StarchedPie/55-microswitch-discipline/README.md

# 55%
 55% keyboard using D2F microswitches, based on Coseyfannitutti's Discipline

[BOM, Build Guide, and Flashing Information](./doc)

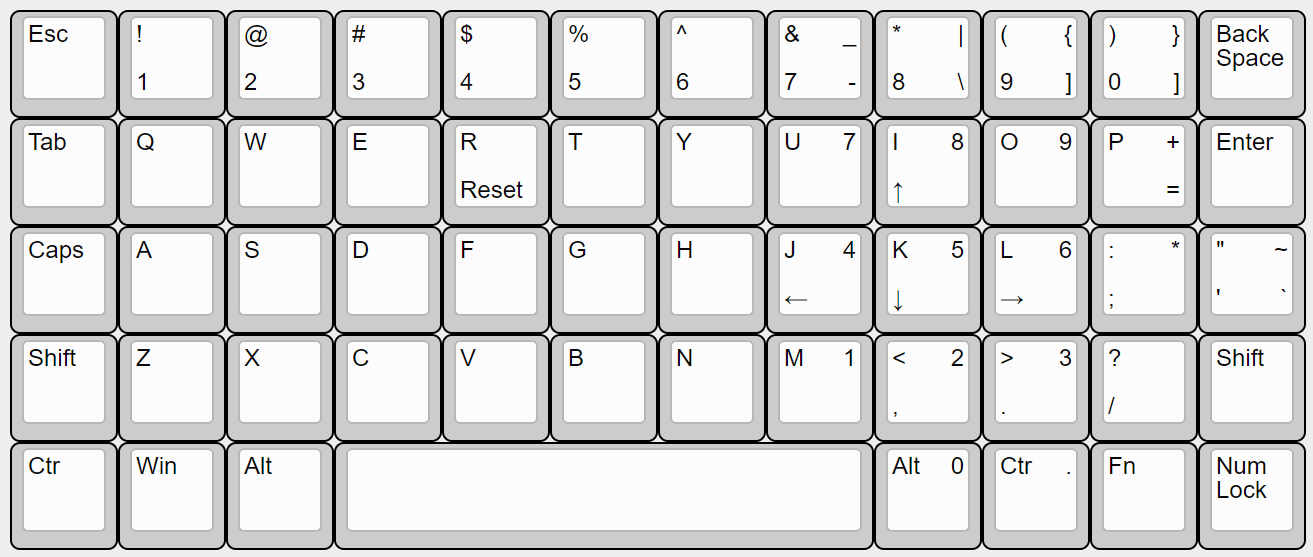
[picture p1: keycaps/Layout.png]
discipline

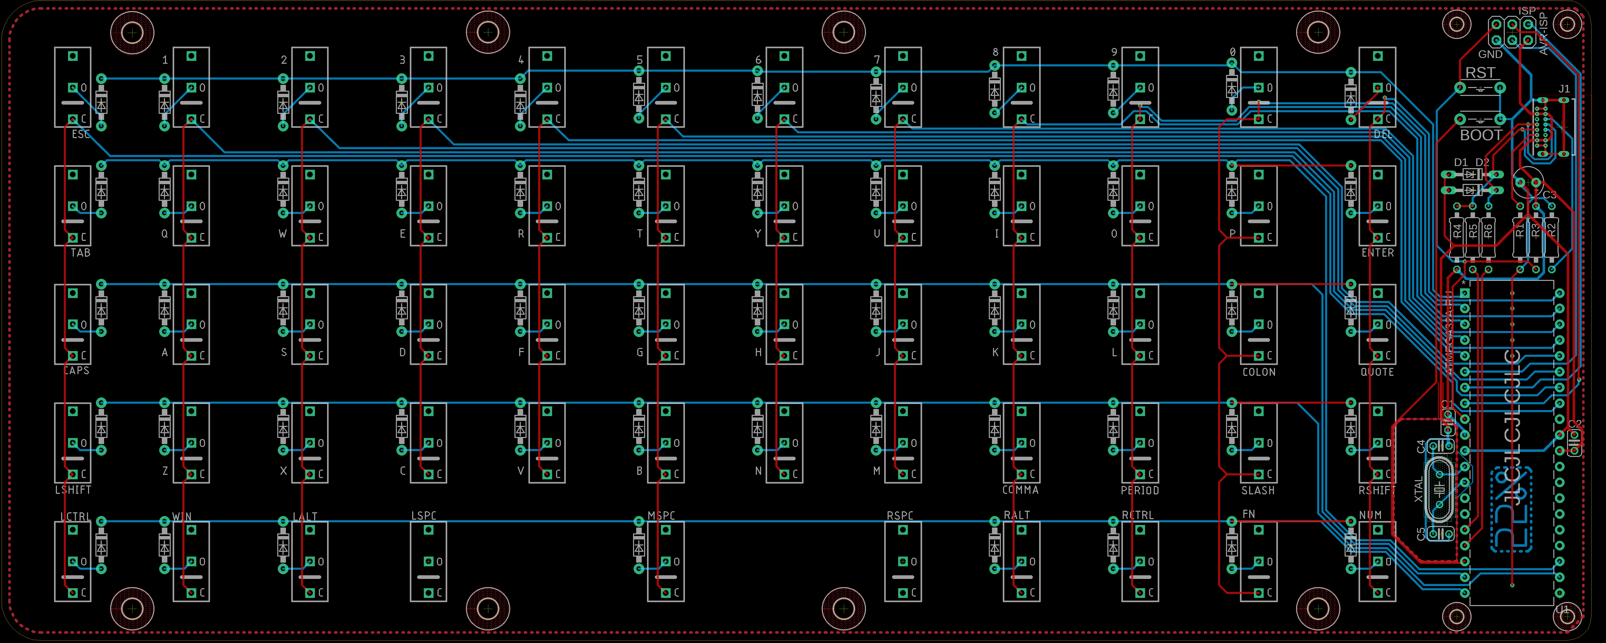
[picture p2: doc/images/PCB_Eagle.png]
