StarchedPie/55-microswitch-discipline/case/README.md

# Lasercut Acrylic Baseplate and Cover

***The Cover is optional, however the Baseplate is strongly recommended, to avoid electrical shorts. The cover needs to be removed for ISP programming***

***I recommend using [Ponoko](https://www.ponoko.com) to cut the pieces. They have all of the correct/required thicknesses and materials in stock and have the best pricing that I have found for multiple one-off parts. Use clear acrylic for the full range of thickness options and Delrin (POM) for the plate. For proper fit please ensure you use the correct dimensions and material thicknesses noted below. Other colors may be used, but of the colors may have limited thickness options, so you may have to narrow material results by thickness to see which colors are available for that size.***

***Ponoko's automatic size detection when uploading is not flawless, so be sure to manually enter the dimensions below.***

## Part Dimensions/Thickness (Top to Bottom)
Baseplate: Baseplate.dxf - 10.05" x 4.05" - ***2mm thickness Delrin***
Cover: Cover.dxf - 1.00" x 4.05" - ***2mm thickness Clear Acrylic***
OR
Both: Baseplate_and_Cover.dxf - 11.2" x 4.05" - ***2mm thickness, Any Plastic***

## Screws and Standoffs
Baseplate: 8x M3 screws, 8x M3 spacers, 8x M3 nuts; 10mm screws recommended for use with 3mm spacers.
Only Baseplate: Add 4x M2 equivalents to the M3 bolts, spacers and nuts outlined above.
Cover: 4x M2 screws, 4x M2 standoffs, 4x M2 nuts; Standoffs must be at least 10mm to clear components, other lengths should match M3 components (10mm screws, 3mm spacers).
