StarchedPie/55-microswitch-discipline/doc/55percent/readme.md

# 55%

A 55% microswitch keyboard that can be assembled with only through hole components.

* Keyboard Maintainer: [starchedpie](https://github.com/StarchedPie)
* Hardware Supported: atmega32a

Add this folder, "55percent", to the QMK Firmware "keyboards" folder, and follow QMK documentation to create a keymap and compile for atmega32a.

Alternatively, use the 55percent_default.hex file in this folder to flash the default keymap.

See the [build environment setup](https://docs.qmk.fm/#/getting_started_build_tools) and the [make instructions](https://docs.qmk.fm/#/getting_started_make_guide) for more information. Brand new to QMK? Start with our [Complete Newbs Guide](https://docs.qmk.fm/#/newbs).
