StarchedPie/55-microswitch-discipline/case/Cover.dxf

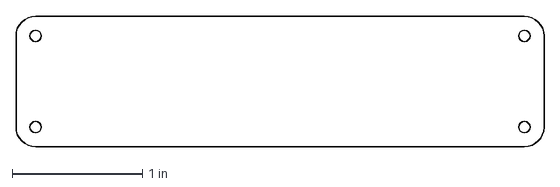
[picture p4: CAD file, 2020-04-17]
case/Cover.dxf
4.05 x 1.00 in
