StarchedPie/55-microswitch-discipline/keycaps/Letters/B.stl

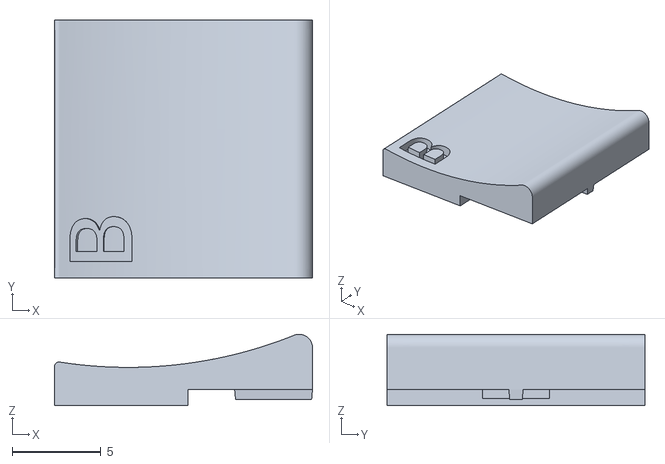
[picture p5: CAD file, 2020-04-17]
keycaps/Letters/B.stl
14.5 x 14.5 x 4.01
