StarchedPie/55-microswitch-discipline/keycaps/Numbers/F10.stl

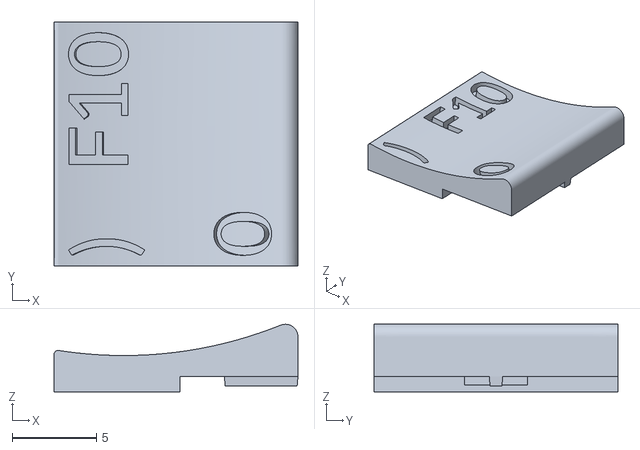
[picture p6: CAD file, 2020-04-17]
keycaps/Numbers/F10.stl
14.5 x 14.5 x 4.01
