StarchedPie/55-microswitch-discipline/keycaps/Special/F0.stl

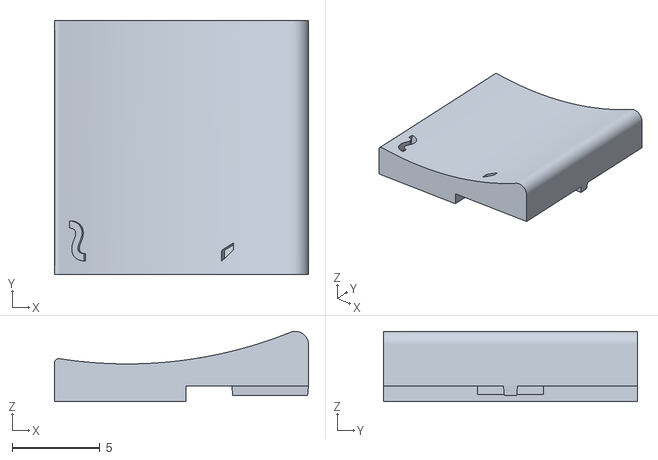
[picture p7: CAD file, 2020-04-17]
keycaps/Special/F0.stl
14.5 x 14.5 x 4.01
