StarchedPie/55-microswitch-discipline/case/Baseplate.dxf

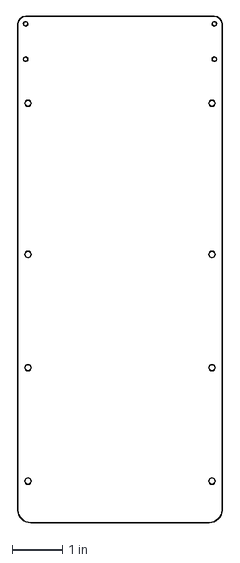
[picture p8: CAD file, 2020-04-17]
case/Baseplate.dxf
4.05 x 10.1 in
