StarchedPie/55-microswitch-discipline/keycaps/Numbers/F3.stl

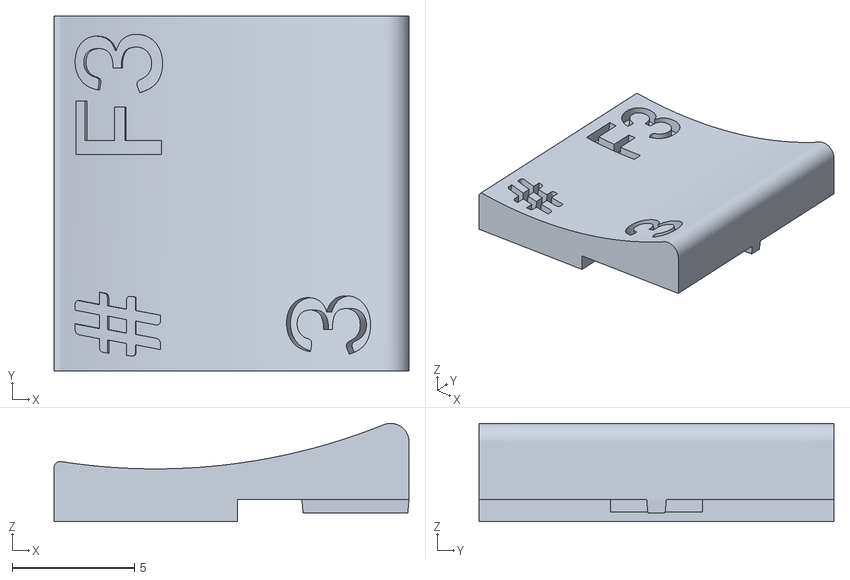
[picture p9: CAD file, 2020-04-17]
keycaps/Numbers/F3.stl
14.5 x 14.5 x 4.01
