StarchedPie/55-microswitch-discipline/keycaps/Special/F-1.stl

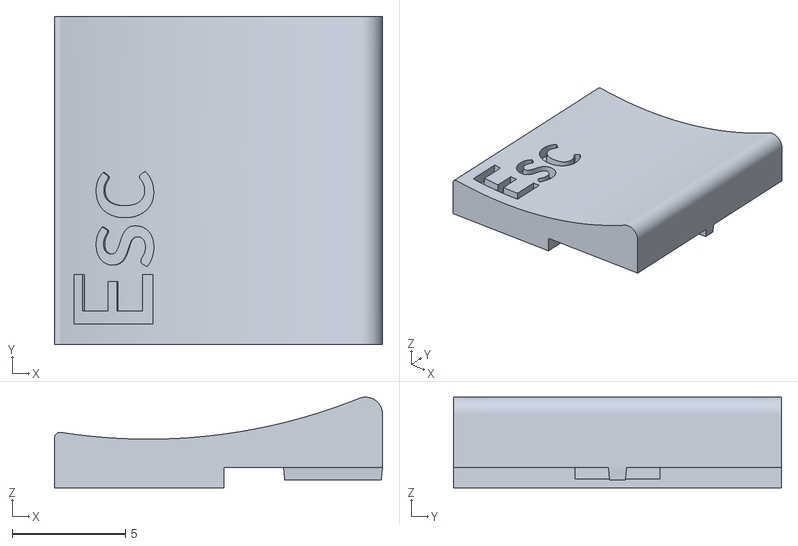
[picture p10: CAD file, 2020-04-17]
keycaps/Special/F-1.stl
14.5 x 14.5 x 4.01
