StarchedPie/55-microswitch-discipline/case/Baseplate_and_Cover.dxf

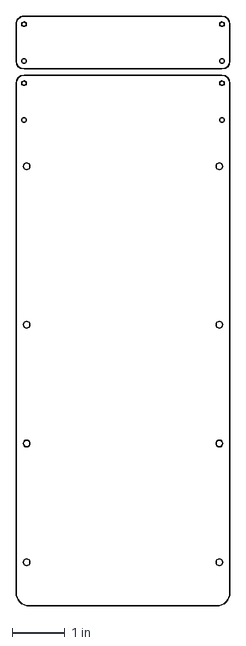
[picture p11: CAD file, 2020-04-17]
case/Baseplate_and_Cover.dxf
4.05 x 11.2 in
