StarchedPie/55-microswitch-discipline/keycaps/Numbers/F6.stl

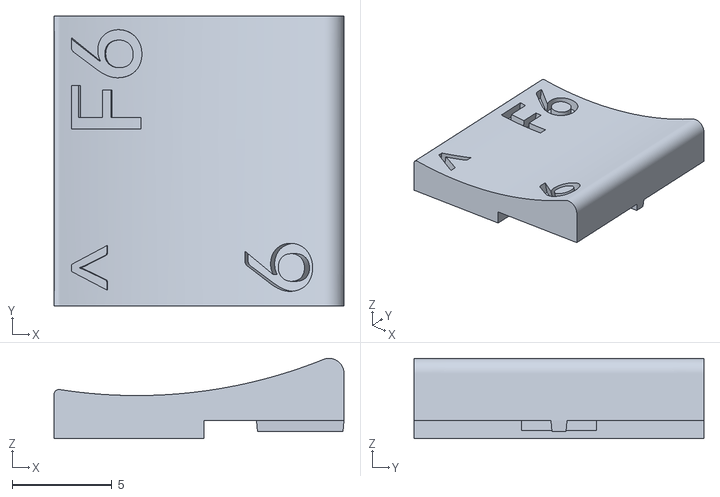
[picture p12: CAD file, 2020-04-17]
keycaps/Numbers/F6.stl
14.5 x 14.5 x 4.01
