StarchedPie/55-microswitch-discipline/keycaps/Special/FMode.stl

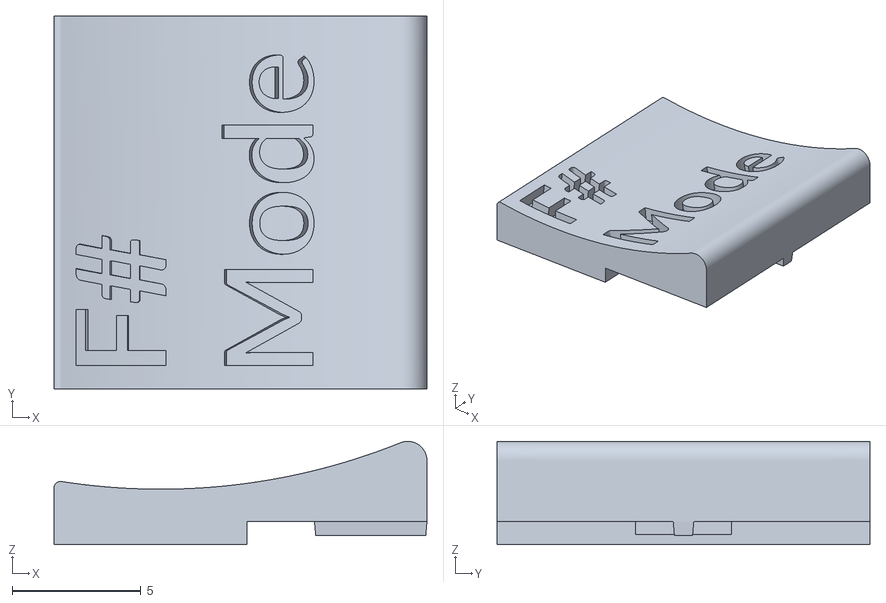
[picture p13: CAD file, 2020-04-17]
keycaps/Special/FMode.stl
14.5 x 14.5 x 4.01
