StarchedPie/55-microswitch-discipline/(list of files, cad)

Other CAD files:
keycaps/Letters/U.stl
keycaps/Letters/A.stl
keycaps/Letters/J.stl
keycaps/Numbers/F4.stl
keycaps/Letters/E.stl
keycaps/Numbers/F5.stl
keycaps/Letters/W.stl
keycaps/Numbers/F8.stl
keycaps/Letters/Z.stl
keycaps/Numbers/F1.stl
keycaps/Letters/L.stl
keycaps/Numbers/F7.stl
keycaps/Letters/S.stl
keycaps/Numbers/F2.stl
keycaps/Letters/T.stl
keycaps/Numbers/F9.stl
keycaps/Letters/K.stl
keycaps/Letters/V.stl
keycaps/Letters/H.stl
keycaps/Letters/G.stl
keycaps/Letters/D.stl
keycaps/Letters/R.stl
keycaps/Letters/C.stl
keycaps/Letters/Q.stl
keycaps/Letters/O.stl
keycaps/Letters/I.stl
keycaps/Letters/P.stl
keycaps/Letters/X.stl
keycaps/Letters/N.stl
keycaps/Letters/Y.stl
keycaps/Letters/M.stl
keycaps/Letters/F.stl
