StarchedPie/55-microswitch-discipline/55percent.brd

## EAGLE design 55percent.brd (2020-04-21)

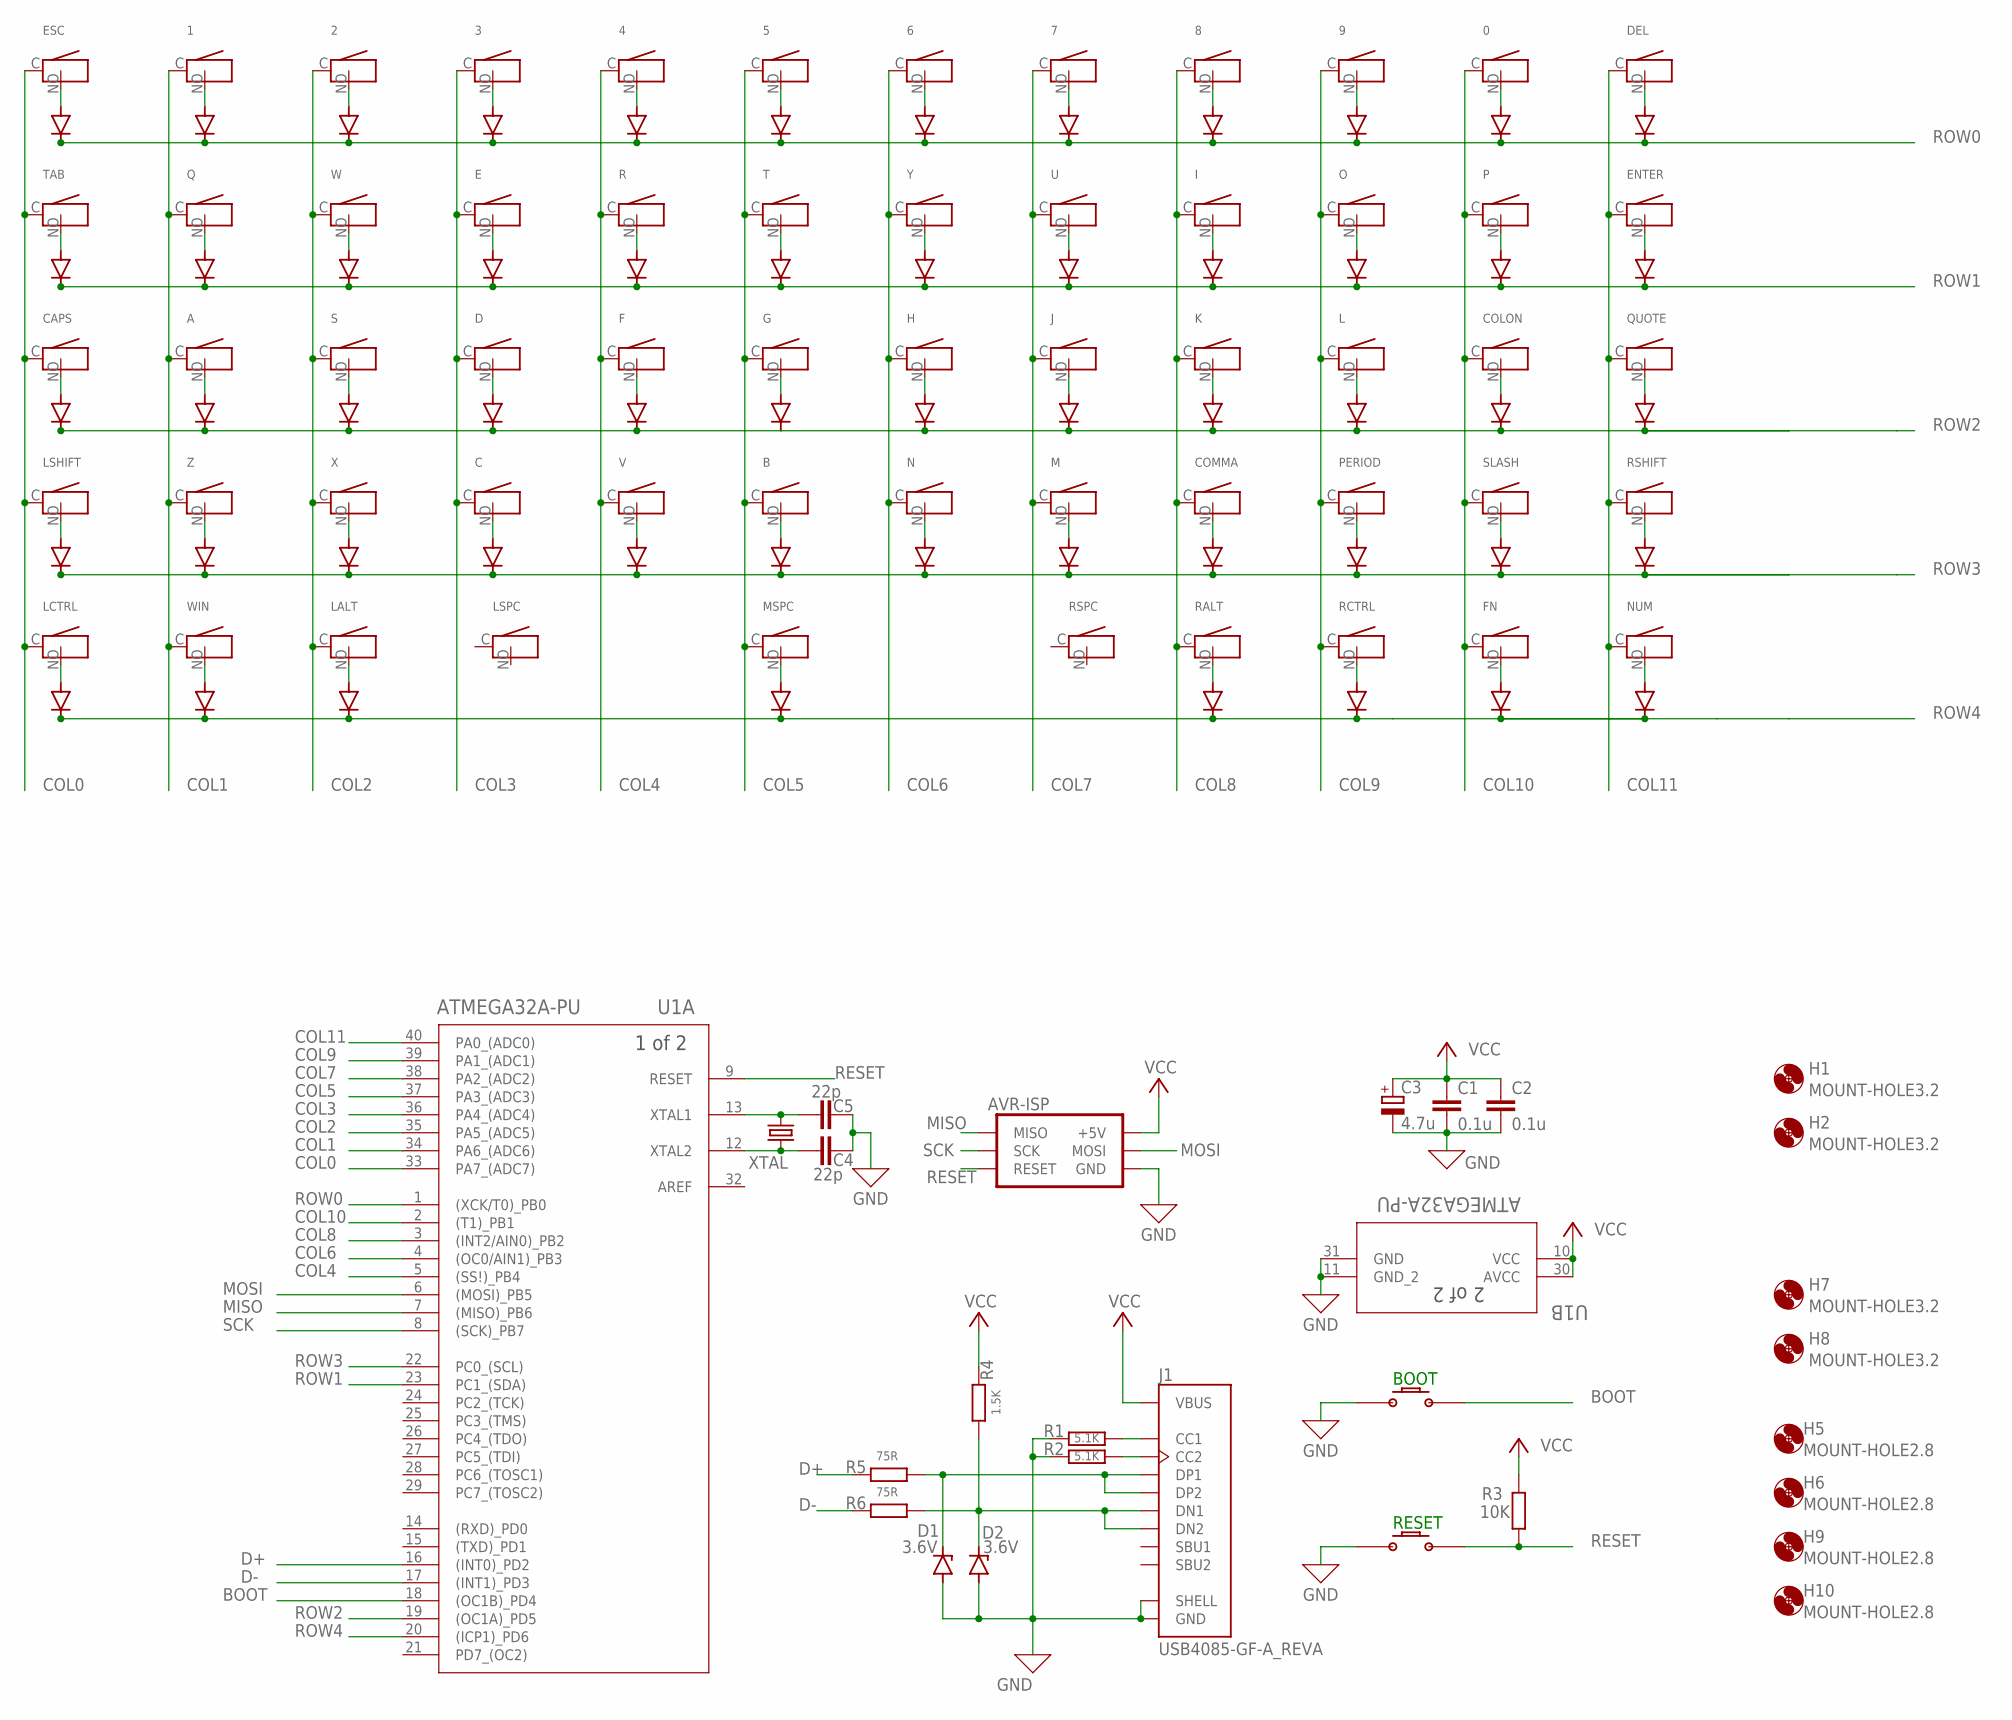
[picture p14: schematic 55percent.sch]

Parts:
0, 1, 2, 3, 4, 5, 6, 7, 8, 9: D2F_MICROSWITCH
A: D2F_MICROSWITCH
B: D2F_MICROSWITCH
C: D2F_MICROSWITCH
C1, C2: 0.1u; C025-024X044
C3: 4.7u; E2,5-5
C4, C5: 22p; C025-024X044
CAPS: D2F_MICROSWITCH
COLON: D2F_MICROSWITCH
COMMA: D2F_MICROSWITCH
D: D2F_MICROSWITCH
D1, D2: 3.6V; DO34Z7
D3, D4, D5, D6, D7, D8, D9, D10, D11, D12, D13, D14, D15, D16, D17, D18, D19, D20, D21, D23, D24, D25, D26, D28, D29, D30, D31, D32, D33, D34, D35, D36, D38, D39, D40, D41, D43, D44, D45, D46, D47, D48, D49, D50, D51, D52, D53, D54, D55, D56, D57, D58, D59, D60, D61, D62: 1N4004; DO41-10
DEL: D2F_MICROSWITCH
E: D2F_MICROSWITCH
ENTER: D2F_MICROSWITCH
ESC: D2F_MICROSWITCH
F: D2F_MICROSWITCH
FN: D2F_MICROSWITCH
G: D2F_MICROSWITCH
H: D2F_MICROSWITCH
H1, H2, H7, H8: MOUNT-HOLE3.2; 3,2
H5, H6, H9, H10: MOUNT-HOLE2.8; 2,2
I: D2F_MICROSWITCH
J: D2F_MICROSWITCH
J1: USB4085-GF-A_REVA; GCT_USB4085-GF-A_REVA
JP1: PINHD-2X3; 2X03
K: D2F_MICROSWITCH
L: D2F_MICROSWITCH
LALT: D2F_MICROSWITCH
LCTRL: D2F_MICROSWITCH
LSHIFT: D2F_MICROSWITCH
LSPC: D2F_MICROSWITCH
M: D2F_MICROSWITCH
MSPC: D2F_MICROSWITCH
N: D2F_MICROSWITCH
NUM: D2F_MICROSWITCH
O: D2F_MICROSWITCH
P: D2F_MICROSWITCH
PERIOD: D2F_MICROSWITCH
Q: D2F_MICROSWITCH
QUOTE: D2F_MICROSWITCH
R: D2F_MICROSWITCH
R1, R2: 5.1K; 0207/10
R3: 10K; 0207/10
R4: 1.5K; 0207/10
R5, R6: 75R; 0207/10
RALT: D2F_MICROSWITCH
RCTRL: D2F_MICROSWITCH
RSHIFT: D2F_MICROSWITCH
RSPC: D2F_MICROSWITCH
S: D2F_MICROSWITCH
SLASH: D2F_MICROSWITCH
T: D2F_MICROSWITCH
TAB: D2F_MICROSWITCH
U: D2F_MICROSWITCH
U1: ATMEGA32A-PU; 40P6
U$1, U$2: PTS636SK43LFS; PTS636SK43LFSTHT
V: D2F_MICROSWITCH
W: D2F_MICROSWITCH
WIN: D2F_MICROSWITCH
X: D2F_MICROSWITCH
XTAL: CRYSTALHC49S; HC49/S
Y: D2F_MICROSWITCH
Z: D2F_MICROSWITCH

Connections:
BOOT: U1.18 ((OC1B)_PD4), U$1.P$2
COL0: CAPS.C, ESC.C, LCTRL.C, LSHIFT.C, TAB.C, U1.33 (PA7_(ADC7))
COL1: 1.C, A.C, Q.C, U1.34 (PA6_(ADC6)), WIN.C, Z.C
COL2: 2.C, LALT.C, S.C, U1.35 (PA5_(ADC5)), W.C, X.C
COL3: 3.C, C.C, D.C, E.C, U1.36 (PA4_(ADC4))
COL4: 4.C, F.C, R.C, U1.5 ((SS!)_PB4), V.C
COL5: 5.C, B.C, G.C, MSPC.C, T.C, U1.37 (PA3_(ADC3))
COL6: 6.C, H.C, N.C, U1.4 ((OC0/AIN1)_PB3), Y.C
COL7: 7.C, J.C, M.C, U.C, U1.38 (PA2_(ADC2))
COL8: 8.C, COMMA.C, I.C, K.C, RALT.C, U1.3 ((INT2/AIN0)_PB2)
COL9: 9.C, L.C, O.C, PERIOD.C, RCTRL.C, U1.39 (PA1_(ADC1))
COL10: 0.C, COLON.C, FN.C, P.C, SLASH.C, U1.2 ((T1)_PB1)
COL11: DEL.C, ENTER.C, NUM.C, QUOTE.C, RSHIFT.C, U1.40 (PA0_(ADC0))
D+: R5.1, U1.16 ((INT0)_PD2)
D-: R6.1, U1.17 ((INT1)_PD3)
GND: C1.2, C2.2, C3.-, C4.1, C5.1, D1.A, D2.A, J1.A1 (GND), J1.A12 (GND), J1.B1 (GND), J1.B12 (GND), J1.P1 (SHELL), J1.P2 (SHELL), J1.P3 (SHELL), J1.P4 (SHELL), JP1.GND, R1.1, R2.1, U1.11 (GND_2), U1.31 (GND), U$1.P$1, U$2.P$1
MISO: JP1.MISO, U1.7 ((MISO)_PB6)
MOSI: JP1.MOSI, U1.6 ((MOSI)_PB5)
unnamed: J1.A5 (CC1), R1.2
unnamed: J1.B5 (CC2), R2.2
unnamed: D1.C, J1.A6 (DP1), J1.B6 (DP2), R5.2
unnamed: D7.A, LCTRL.NO (O)
unnamed: C5.2, U1.13 (XTAL1), XTAL.1
unnamed: C4.2, U1.12 (XTAL2), XTAL.2
unnamed: D2.C, J1.A7 (DN1), J1.B7 (DN2), R4.2, R6.2
unnamed: D6.A, LSHIFT.NO (O)
unnamed: CAPS.NO (O), D5.A
unnamed: D4.A, TAB.NO (O)
unnamed: D3.A, ESC.NO (O)
unnamed: D12.A, WIN.NO (O)
unnamed: D11.A, Z.NO (O)
unnamed: A.NO (O), D10.A
unnamed: D9.A, Q.NO (O)
unnamed: 1.NO (O), D8.A
unnamed: D17.A, LALT.NO (O)
unnamed: D16.A, X.NO (O)
unnamed: D15.A, S.NO (O)
unnamed: D14.A, W.NO (O)
unnamed: 2.NO (O), D13.A
unnamed: C.NO (O), D21.A
unnamed: D.NO (O), D20.A
unnamed: D19.A, E.NO (O)
unnamed: 3.NO (O), D18.A
unnamed: D26.A, V.NO (O)
unnamed: D25.A, F.NO (O)
unnamed: D24.A, R.NO (O)
unnamed: 4.NO (O), D23.A
unnamed: D32.A, MSPC.NO (O)
unnamed: B.NO (O), D31.A
unnamed: D30.A, G.NO (O)
unnamed: D29.A, T.NO (O)
unnamed: 5.NO (O), D28.A
unnamed: D36.A, N.NO (O)
unnamed: D35.A, H.NO (O)
unnamed: D34.A, Y.NO (O)
unnamed: 6.NO (O), D33.A
unnamed: D41.A, M.NO (O)
unnamed: D40.A, J.NO (O)
unnamed: D39.A, U.NO (O)
unnamed: 7.NO (O), D38.A
unnamed: D47.A, RALT.NO (O)
unnamed: COMMA.NO (O), D46.A
unnamed: D45.A, K.NO (O)
unnamed: D44.A, I.NO (O)
unnamed: 8.NO (O), D43.A
unnamed: D52.A, RCTRL.NO (O)
unnamed: D51.A, PERIOD.NO (O)
unnamed: D50.A, L.NO (O)
unnamed: D49.A, O.NO (O)
unnamed: 9.NO (O), D48.A
unnamed: D57.A, FN.NO (O)
unnamed: D56.A, SLASH.NO (O)
unnamed: COLON.NO (O), D55.A
unnamed: D54.A, P.NO (O)
unnamed: 0.NO (O), D53.A
unnamed: D62.A, NUM.NO (O)
unnamed: D61.A, RSHIFT.NO (O)
unnamed: D60.A, QUOTE.NO (O)
unnamed: D59.A, ENTER.NO (O)
unnamed: D58.A, DEL.NO (O)
RESET: JP1.RESET, R3.1, U1.9 (RESET), U$2.P$2
ROW0: D3.C, D8.C, D13.C, D18.C, D23.C, D28.C, D33.C, D38.C, D43.C, D48.C, D53.C, D58.C, U1.1 ((XCK/T0)_PB0)
ROW1: D4.C, D9.C, D14.C, D19.C, D24.C, D29.C, D34.C, D39.C, D44.C, D49.C, D54.C, D59.C, U1.23 (PC1_(SDA))
ROW2: D5.C, D10.C, D15.C, D20.C, D25.C, D30.C, D35.C, D40.C, D45.C, D50.C, D55.C, D60.C, U1.19 ((OC1A)_PD5)
ROW3: D6.C, D11.C, D16.C, D21.C, D26.C, D31.C, D36.C, D41.C, D46.C, D51.C, D56.C, D61.C, U1.22 (PC0_(SCL))
ROW4: D7.C, D12.C, D17.C, D32.C, D47.C, D52.C, D57.C, D62.C, U1.20 ((ICP1)_PD6)
SCK: JP1.SCK, U1.8 ((SCK)_PB7)
VCC: C1.1, C2.1, C3.+, J1.A4 (VBUS), J1.A9 (VBUS), J1.B4 (VBUS), J1.B9 (VBUS), JP1.+5V, R3.2, R4.1, U1.10 (VCC), U1.30 (AVCC)

Notes on the sheet:
BOOT
RESET

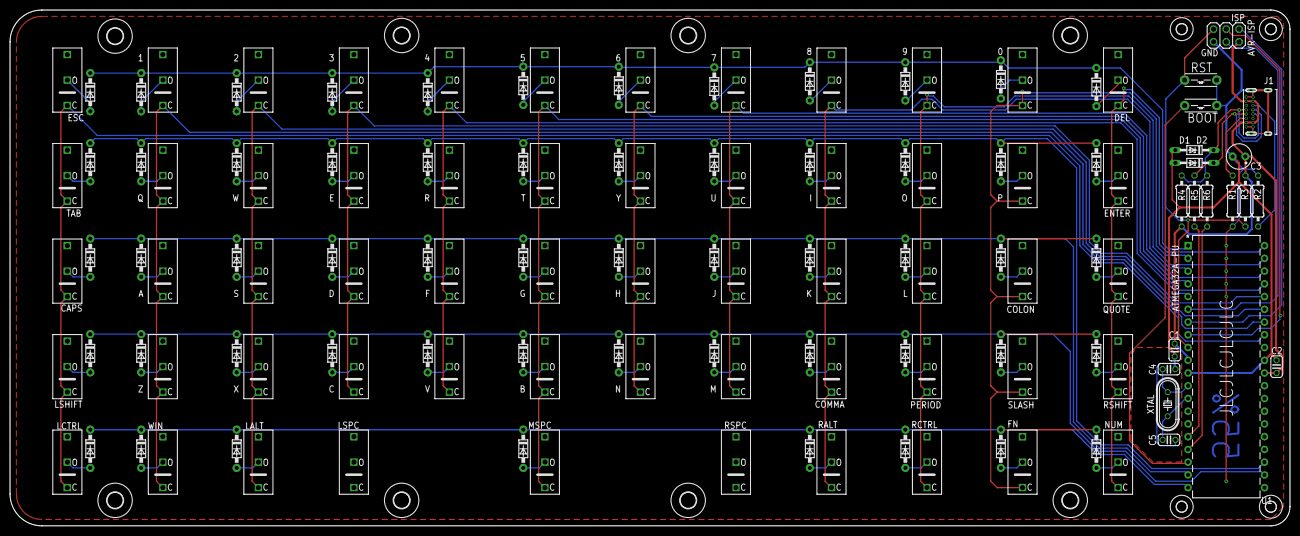
[picture p15: board 55percent.brd from above]

Board: 2 copper layers, 255.3 x 102.9 mm, 145 parts (0 on the bottom side), 88 nets.

Other parts of the board:
H3, H4, H11, H12: MOUNT-HOLE3.2; 3,2
