StarchedPie/55-microswitch-discipline/(commit log)

2020-04-17 Removed DISCIPLINE specific files, replaced with 55% files
    [55percent.brd, 55percent.sch, acrylic-guard.dxf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]
2020-04-17 Keycap STL files added
    [A.stl, B.stl, C.stl, D.stl, E.stl, F-1.stl, F.stl, F0.stl]
2020-04-17 Create BOM
2020-04-17 Update BOM
2020-04-21 Fixed Resistor Placement
    If you have used a prior version of any of these files, contact me
    [55percent.brd, 55percent.sch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]
